gblach/AudioLink/pcb/fab/gerbers/AudioLink-drill-report.txt

Drill report for AudioLink.kicad_pcb
Created on 2026-09-14T11:38:49

Copper Layer Stackup:
    =============================================================
    L1 :  F.Cu                      front
    L2 :  In1.Cu                    in1
    L3 :  In2.Cu                    in2
    L4 :  B.Cu                      back

Drill file 'AudioLink-PTH.drl' contains
    plated through holes:
    =============================================================
    T1  0.300mm  0.0118"  (271 holes))
    T2  0.500mm  0.0197"  (32 holes))
    T3  0.600mm  0.0236"  (4 holes)  (with 4 slots)
    T4  0.650mm  0.0256"  (10 holes))
    T5  1.500mm  0.0591"  (12 holes))
    T6  2.700mm  0.1063"  (4 holes))

    Total plated holes count 333

Drill file 'AudioLink-NPTH.drl' contains
    unplated through holes:
    =============================================================
    T1  0.650mm  0.0256"  (2 holes))

    Total unplated holes count 2
