gblach/AudioLink/pcb/fab/AudioLink-BOM.csv

Item | Designator | Qty | Manufacturer | MPN | Value | Footprint | Type | Notes
1 | C1 | 1 |  |  | 4u7/10V/X7R | C_0805 | SMD | LCSC: https://www.lcsc.com/search?q=4.7uF+0805+10V+X7R
2 | C2,C6,C9,C11,C18-C20,C22,C24,C34-C43 | 19 |  |  | 100n/25V/X7R | C_0603 | SMD | LCSC: https://www.lcsc.com/search?q=100nF+0603+25V+X7R
3 | C3 | 1 |  |  | 10n/50V/X7R | C_0603 | SMD | LCSC: https://www.lcsc.com/search?q=10nF+0603+50V+X7R
4 | C4,C7,C17,C26,C29 | 5 |  |  | 1u/16V/X7R | C_0603 | SMD | LCSC: https://www.lcsc.com/search?q=1uF+0603+16V+X7R
5 | C5,C8,C21,C23,C25 | 5 |  |  | 10u/10V/X7R | C_0805 | SMD | LCSC: https://www.lcsc.com/search?q=10uF+0805+10V+X7R
6 | C10 | 1 |  |  | 22u/10V/X7R | C_0805 | SMD | LCSC: https://www.lcsc.com/search?q=22uF+0805+10V+X7R
7 | C12-C14 | 3 |  |  | 10u/16V/X7R | C_0805 | SMD | LCSC: https://www.lcsc.com/search?q=10uF+0805+16V+X7R
8 | C15,C16 | 2 |  |  | 7p/50V/C0G | C_0603 | SMD | LCSC: https://www.lcsc.com/search?q=7pF+0603+50V+C0G. C0G required - crystal load capacitor
9 | C27,C28 | 2 |  |  | 2u2/16V/X7R | C_0603 | SMD | LCSC: https://www.lcsc.com/search?q=2.2uF+0603+16V+X7R
10 | C30-C33 | 4 |  |  | 100p/50V/C0G | C_0603 | SMD | LCSC: https://www.lcsc.com/search?q=100pF+0603+50V+C0G. C0G required - audio output EMI shunt
11 | D1-D4 | 4 | Worldsemi | WS2812B-4020-V6 | WS2812B-4020-V6 | LED_WS2812B-4020 | SMD | LCSC C52941387 - https://www.lcsc.com/search?q=C52941387
12 | D5 | 1 | Gui guang light | GL0603UB01 | Blue | LED_0603 | SMD | LCSC C51933294 - https://www.lcsc.com/search?q=C51933294. Low-Vf blue, 2.6-2.9V - needed because R19 leaves only 0.4-0.7V across it from the 3V3 rail
13 | D6 | 1 | STMicroelectronics | USBLC6-2SC6 | USBLC6-2SC6 | SOT-23-6 | SMD | LCSC C7519 - https://www.lcsc.com/search?q=C7519. Genuine ST. Cheaper UMW equivalent C2687116 - https://www.lcsc.com/search?q=C2687116
14 | FB1 | 1 | Murata | BLM18PG221SN1D | 220R@100MHz | R_0603 | SMD | LCSC C80165 - https://www.lcsc.com/search?q=C80165
15 | L1,L2 | 2 | Sunlord | SWPA4020S4R7MT | 4u7/1.34A | L_Bourns-SRN4018 | SMD | LCSC C48427 - https://www.lcsc.com/search?q=C48427
16 | R1,R2 | 2 |  |  | 5k1/1% | R_0603 | SMD | LCSC: https://www.lcsc.com/search?q=5.1k+0603+1%. 1% required - USB-C CC pulldown
17 | R3,R12,R13 | 3 |  |  | 100k | R_0603 | SMD | LCSC: https://www.lcsc.com/search?q=100k+0603
18 | R4,R5 | 2 |  |  | 4k7 | R_0603 | SMD | LCSC: https://www.lcsc.com/search?q=4.7k+0603
19 | R7,R17,R18 | 3 |  |  | 0R | R_0603 | SMD | LCSC: https://www.lcsc.com/search?q=0R+0603
20 | R8-R11 | 4 |  |  | 100R/1% | R_0805 | SMD | LCSC: https://www.lcsc.com/search?q=100R+0805+1%. 1% required - these set the balanced source impedance and CMRR
21 | R14,R15 | 2 |  |  | 10k | R_0603 | SMD | LCSC: https://www.lcsc.com/search?q=10k+0603
22 | R16,R19 | 2 |  |  | 470R | R_0603 | SMD | LCSC: https://www.lcsc.com/search?q=470R+0603
23 | U1 | 1 | MinewSemi | MS45SF1-1Y40AIR | MS45SF1 | MinewSemi_MS45SF1 | SMD | Digikey - https://www.digikey.com/en/products/result?keywords=MS45SF1-1Y40AIR. Not stocked at LCSC
24 | U2 | 1 | Texas Instruments | PCM5242RHBR | PCM5242 | VQFN-32 | SMD | LCSC C471871 - https://www.lcsc.com/search?q=C471871
25 | U3,U4 | 2 | Texas Instruments | OPA1678IDR | OPA1678 | SOIC-8 | SMD | LCSC C192421 - https://www.lcsc.com/search?q=C192421
26 | U5 | 1 | Vishay | DG419DY-T1-E3 | DG419 | SOIC-8 | SMD | LCSC C6581 - https://www.lcsc.com/search?q=C6581
27 | U6 | 1 | Texas Instruments | TPS65133DPDR | TPS65133 | WSON-12 | SMD | LCSC C134100 - https://www.lcsc.com/search?q=C134100
28 | U7,U8 | 2 | Texas Instruments | TLV75533PDBVR | TLV75533 | SOT-23-5 | SMD | LCSC C404027 - https://www.lcsc.com/search?q=C404027
29 | Y1 | 1 | Seiko Epson | FC-135 32.7680KA-A5 | 32.768kHz/7pF | Crystal_SMD_3215 | SMD | Digikey - https://www.digikey.com/en/products/result?keywords=FC-135+32.7680KA-A5. LCSC equivalent: Seiko SC-32S C97604, same 3215 / 7pF / 20ppm - https://www.lcsc.com/search?q=C97604
30 | J1,J2 | 2 | Neutrik | NRJ6HM-1 | 6.35mm TRS | Jack_6.35mm_Neutrik_NRJ6HM-1_TrimCrtYd | THT | Mouser 568-NRJ6HM1 - https://www.mouser.com/c/?q=NRJ6HM-1
31 | J3 | 1 | SHOU HAN | TYPE-C 16PIN 2MD(073) | USB-C | USB_C_Receptacle_HCTL_HC-TYPE-C | THT | LCSC C2765186 - https://www.lcsc.com/search?q=C2765186
32 | J4 | 1 | Wurth Elektronik | 62201021621 | SWD | PinHeader_2x05_P1.27mm_Vertical | THT | Digikey - https://www.digikey.com/en/products/result?keywords=62201021621
