gblach/AudioLink/pcb/fab/AudioLink-assembly-top.pdf

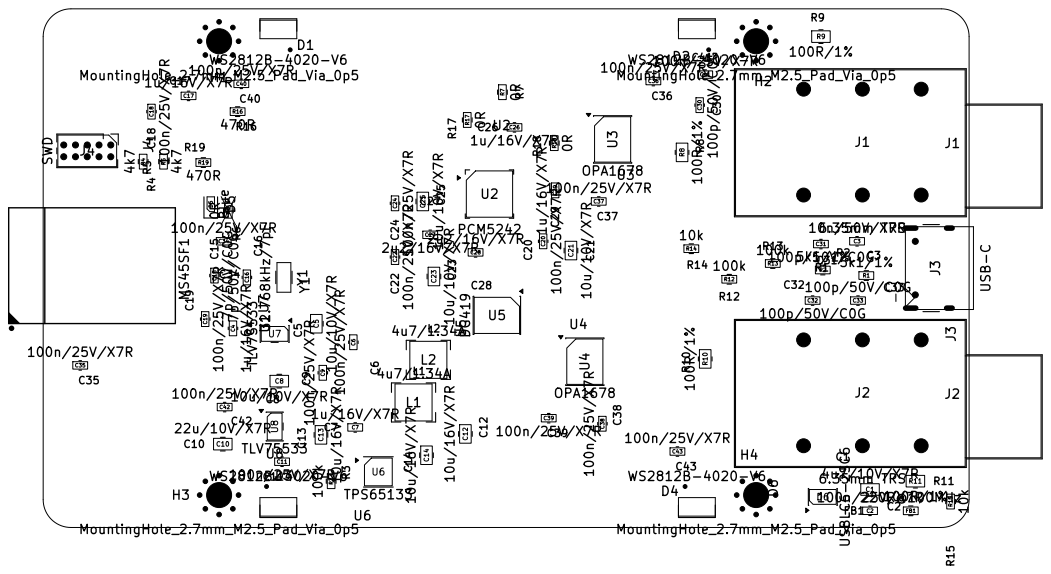
[picture p5: page 1]

Size: A4 | Rev: 1.0
KiCad E.D.A. 10.0.6 | Id: 1/1
