gblach/AudioLink/pcb/fab/AudioLink-schematic.pdf

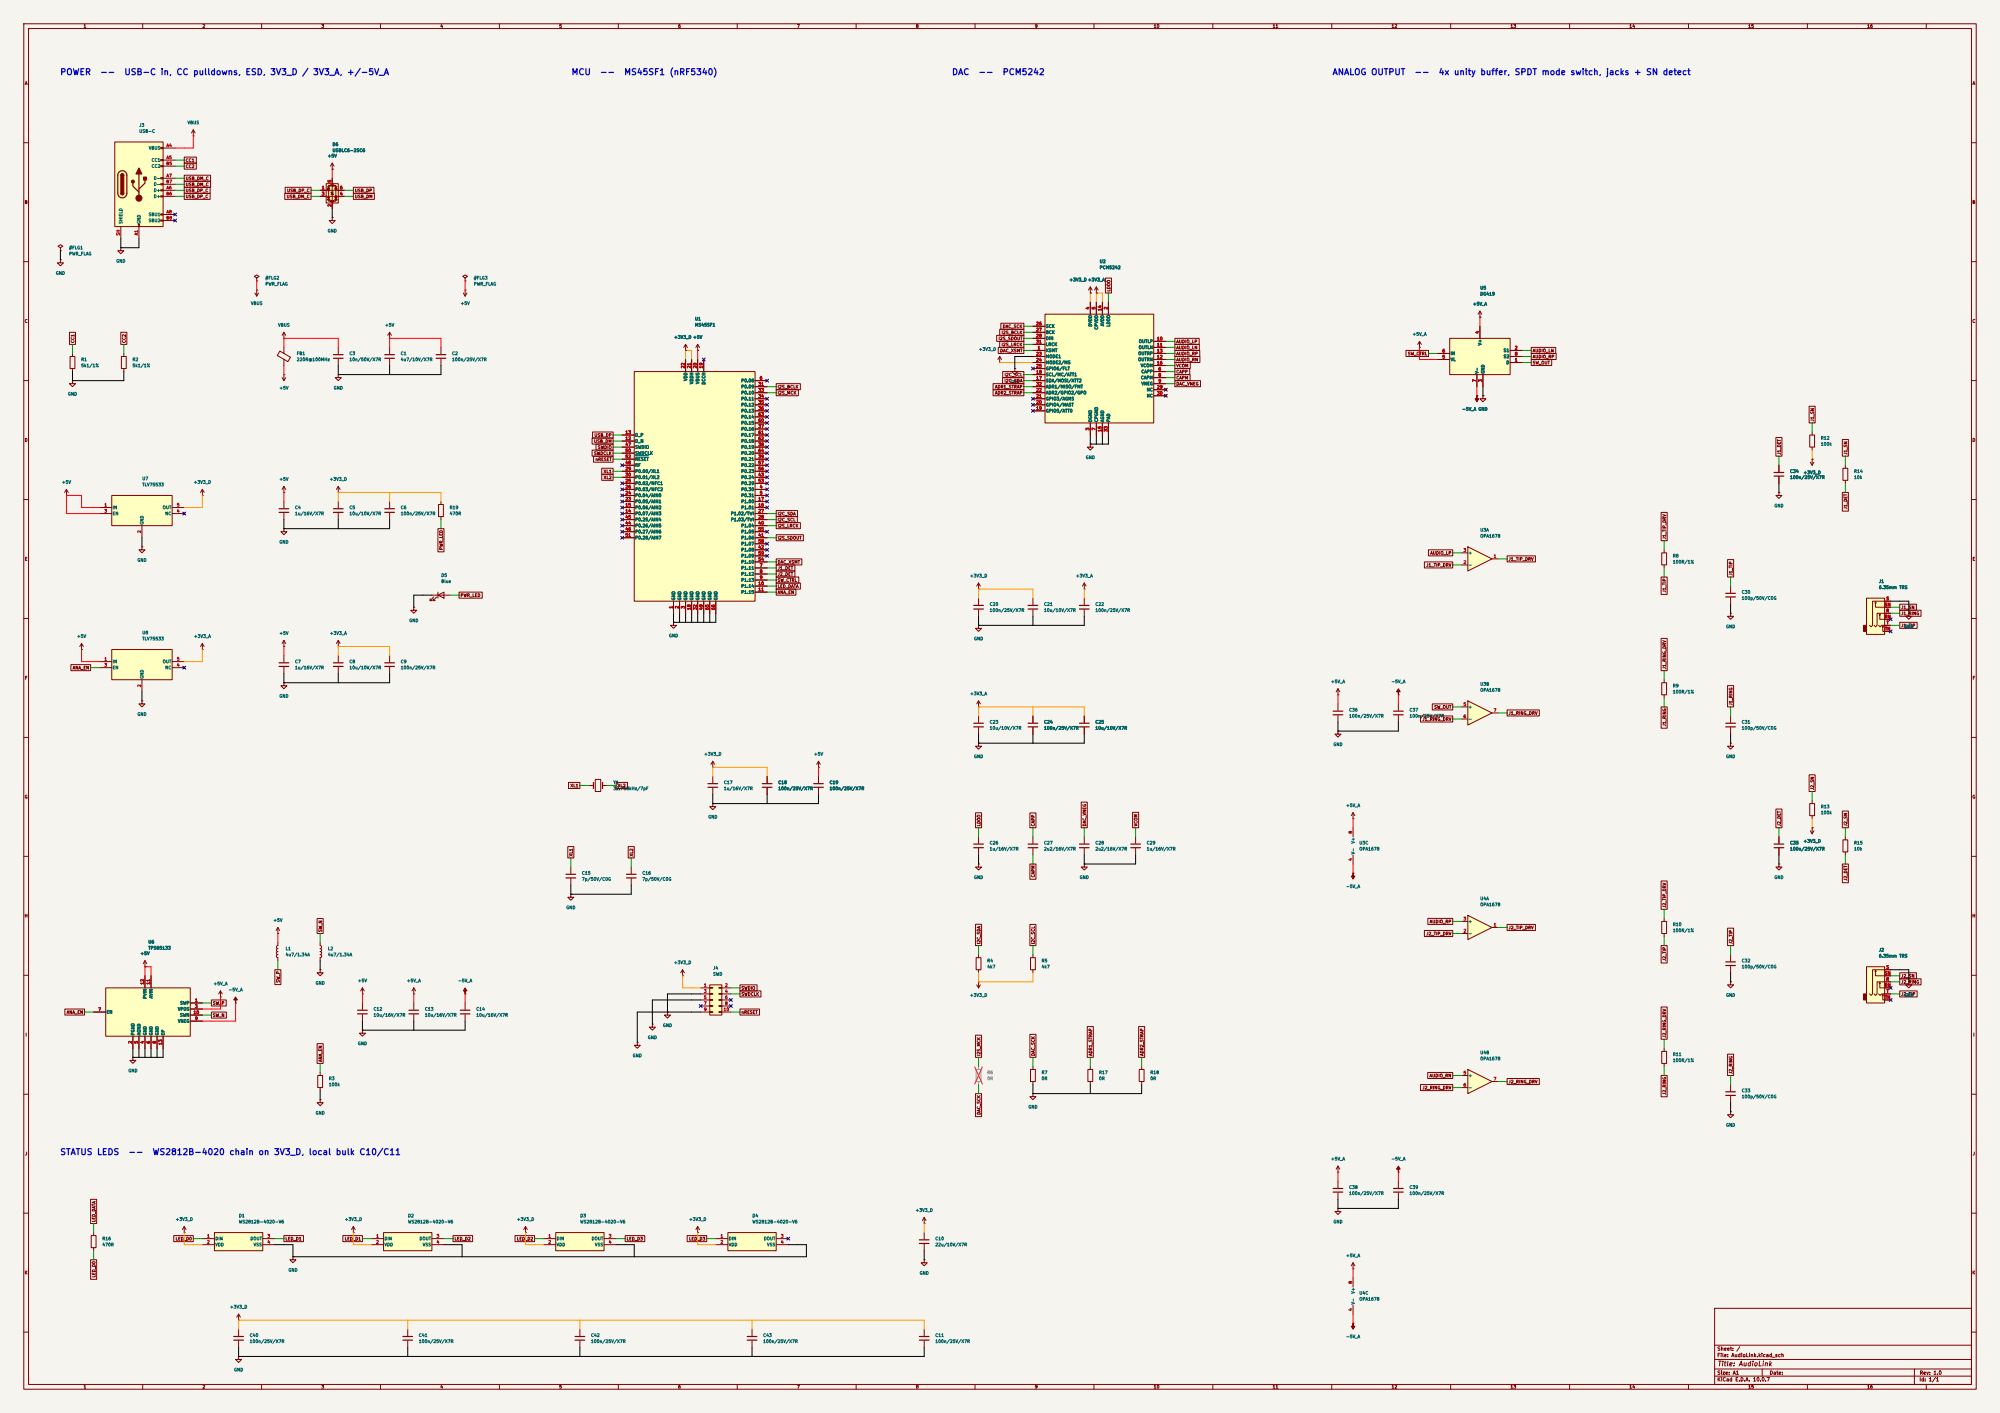
[picture p6: page 1]

3 P0.30 4 P0.31 5 P0.08 6 P1.11 7 P1.12 8 P1.13 9 P1.14 10 P1.15 11 D_N 12 D_P 13 P0.07/AIN3 14 P0.06/AIN2 15 P1.01 16 P1.00 17 GND 18 DCCH 19 VBUS 20 VDDH 21 VDD 22

STATUS LEDS -- WS2812B-4020 chain on 3V3_D, local bulk C10/C11

Size: A1 | Rev: 1.0
KiCad E.D.A. 10.0.7 | Id: 1/1
