gblach/AudioLink/pcb/AudioLink.kicad_pcb

## KiCad design pcb/AudioLink.kicad_pcb (2026-10-31)

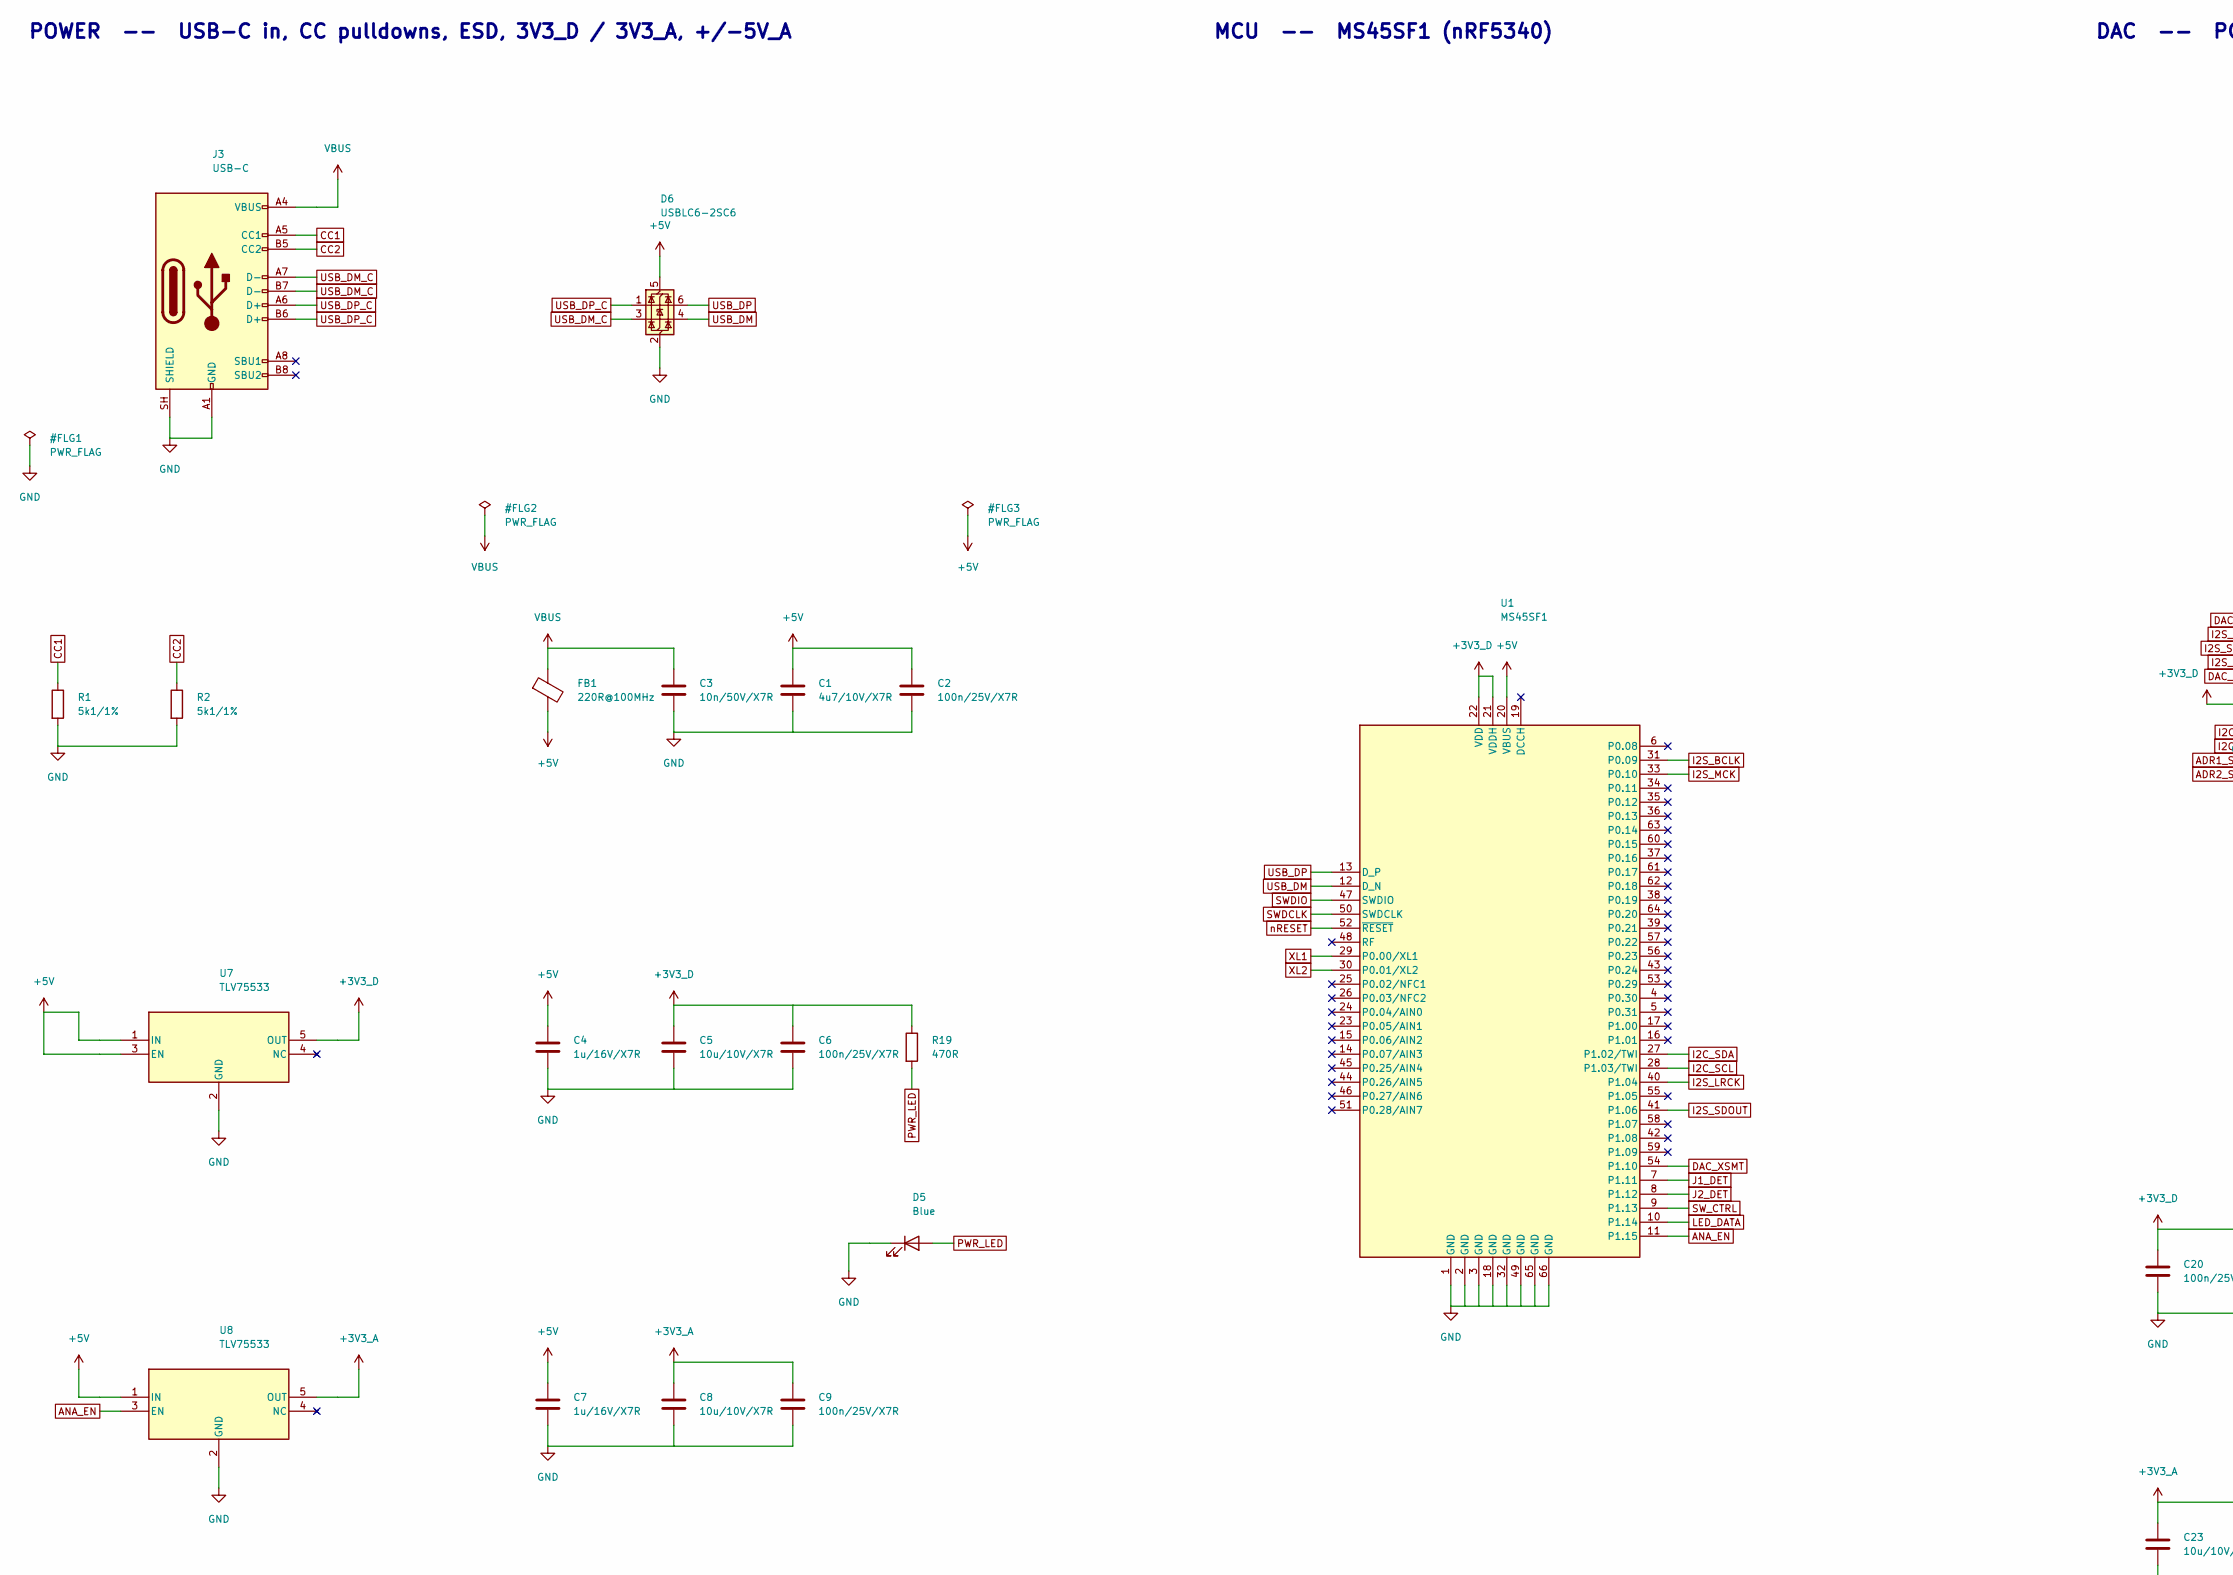
[picture p7: schematic AudioLink.kicad_sch, part in row 1, column 1]

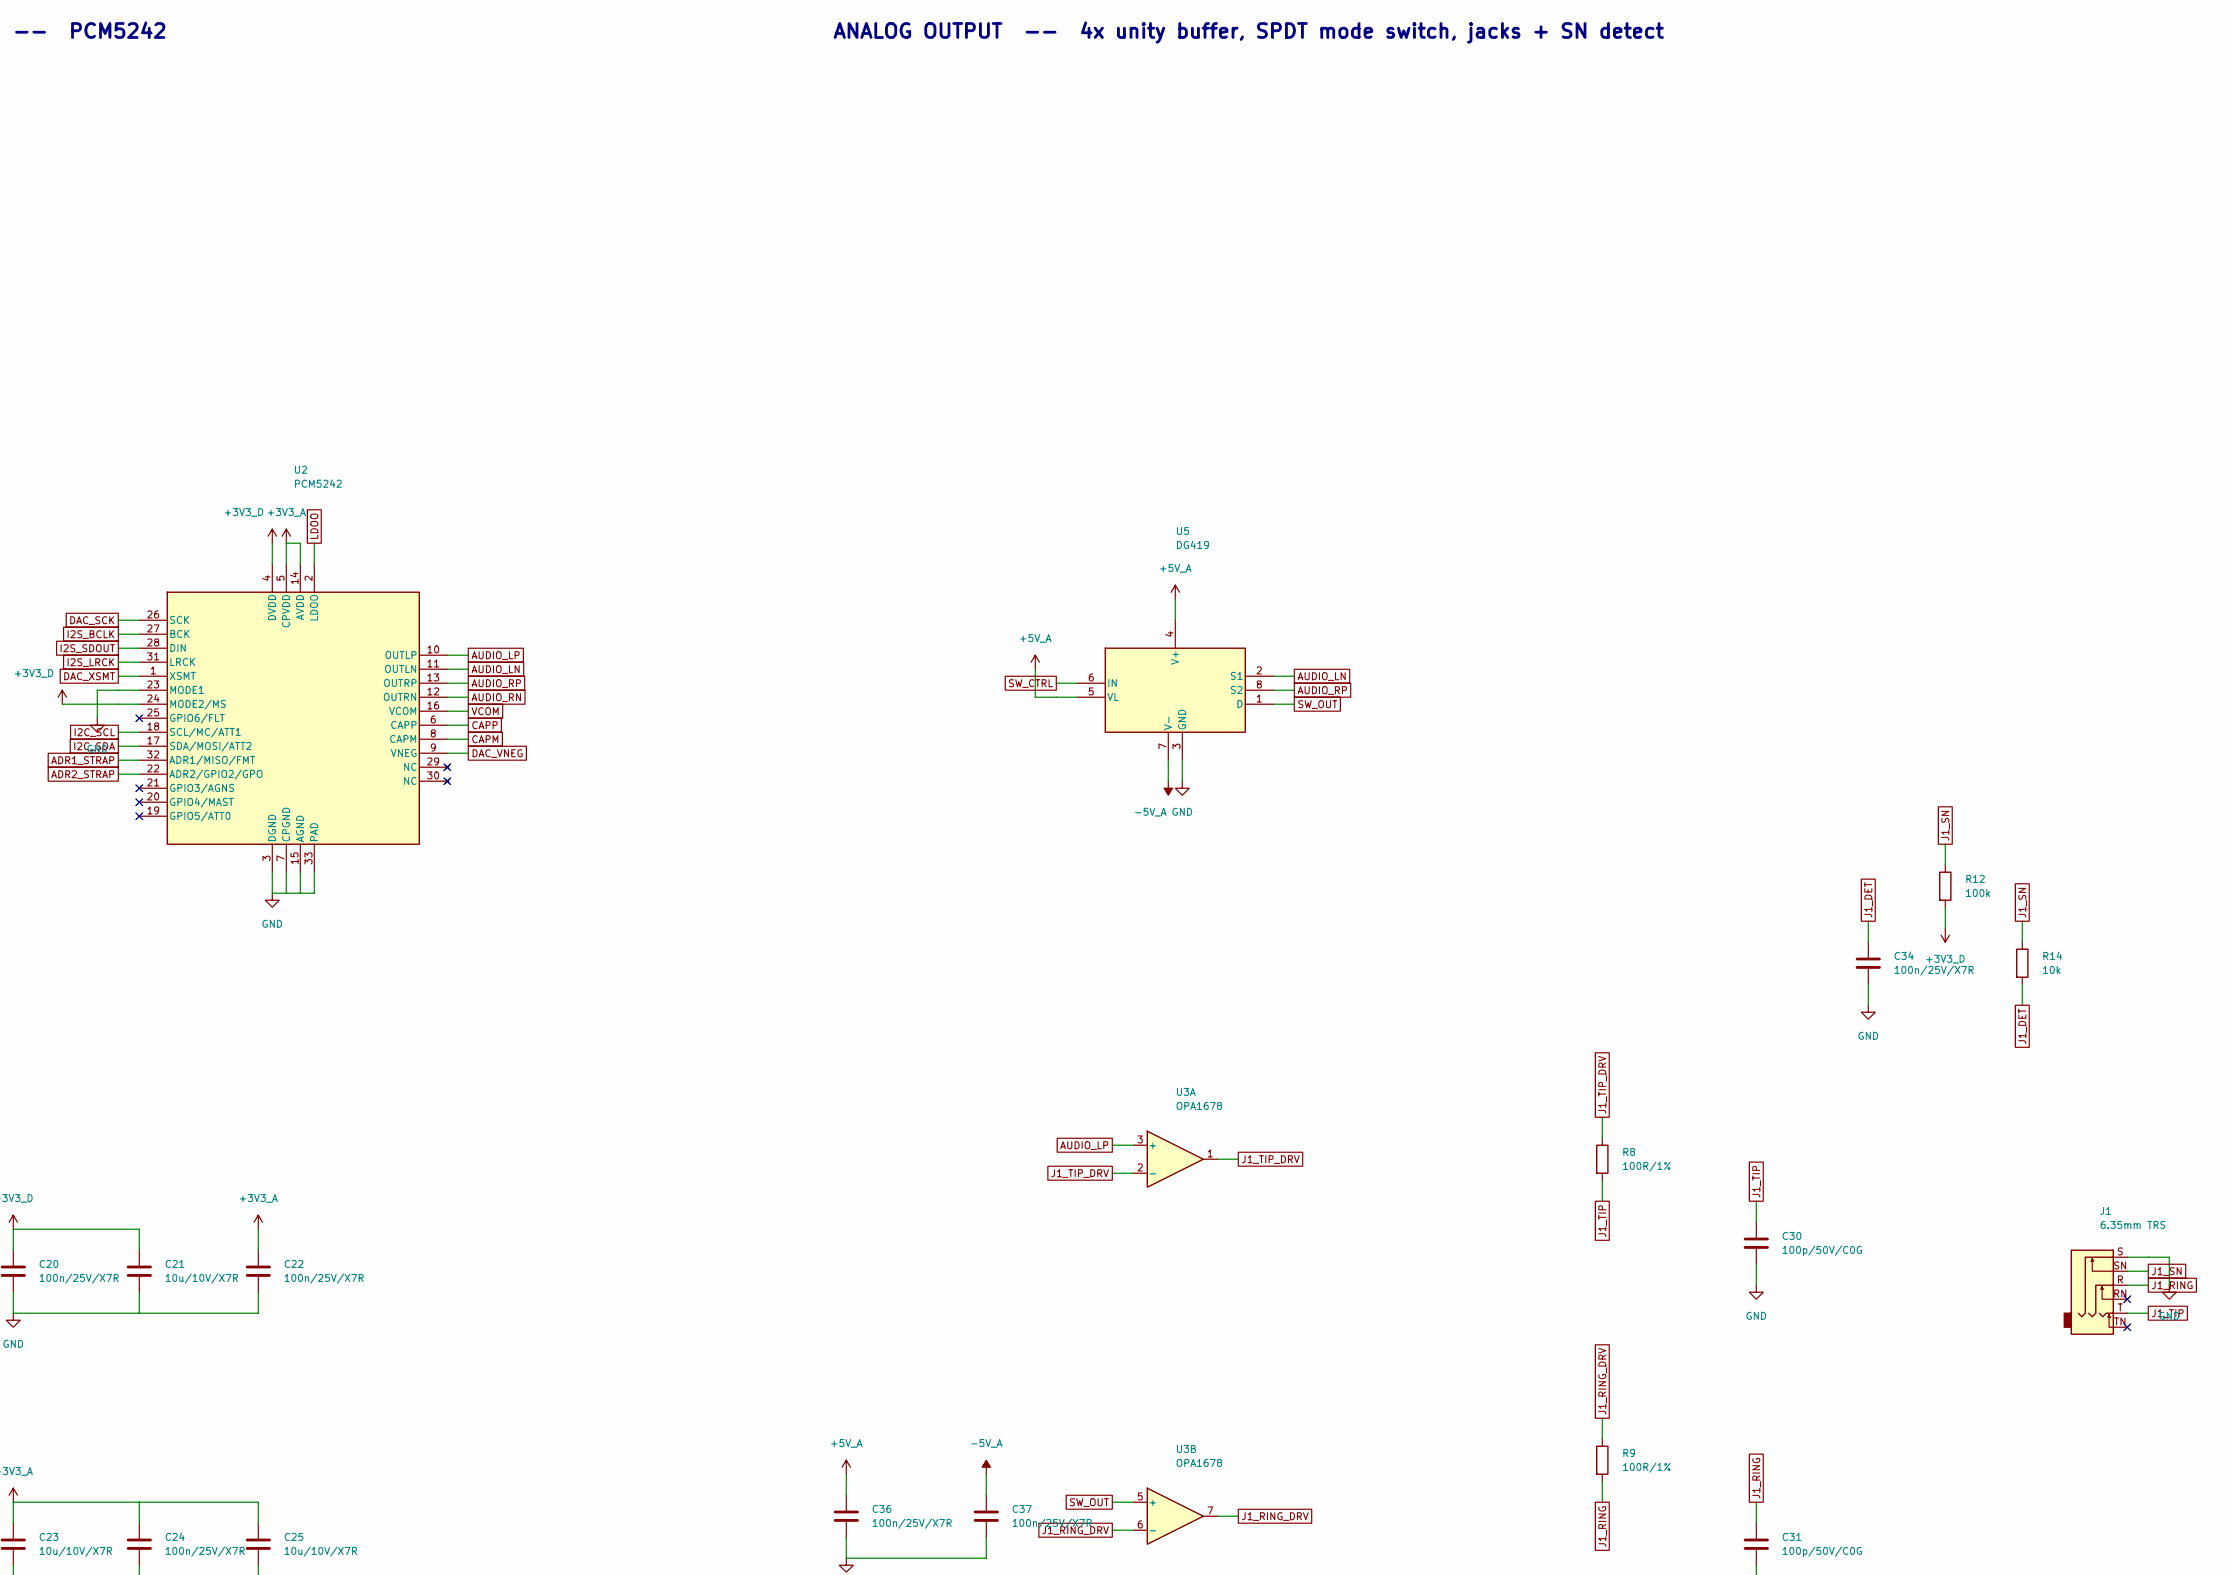
[picture p8: schematic AudioLink.kicad_sch, part in row 1, column 2]

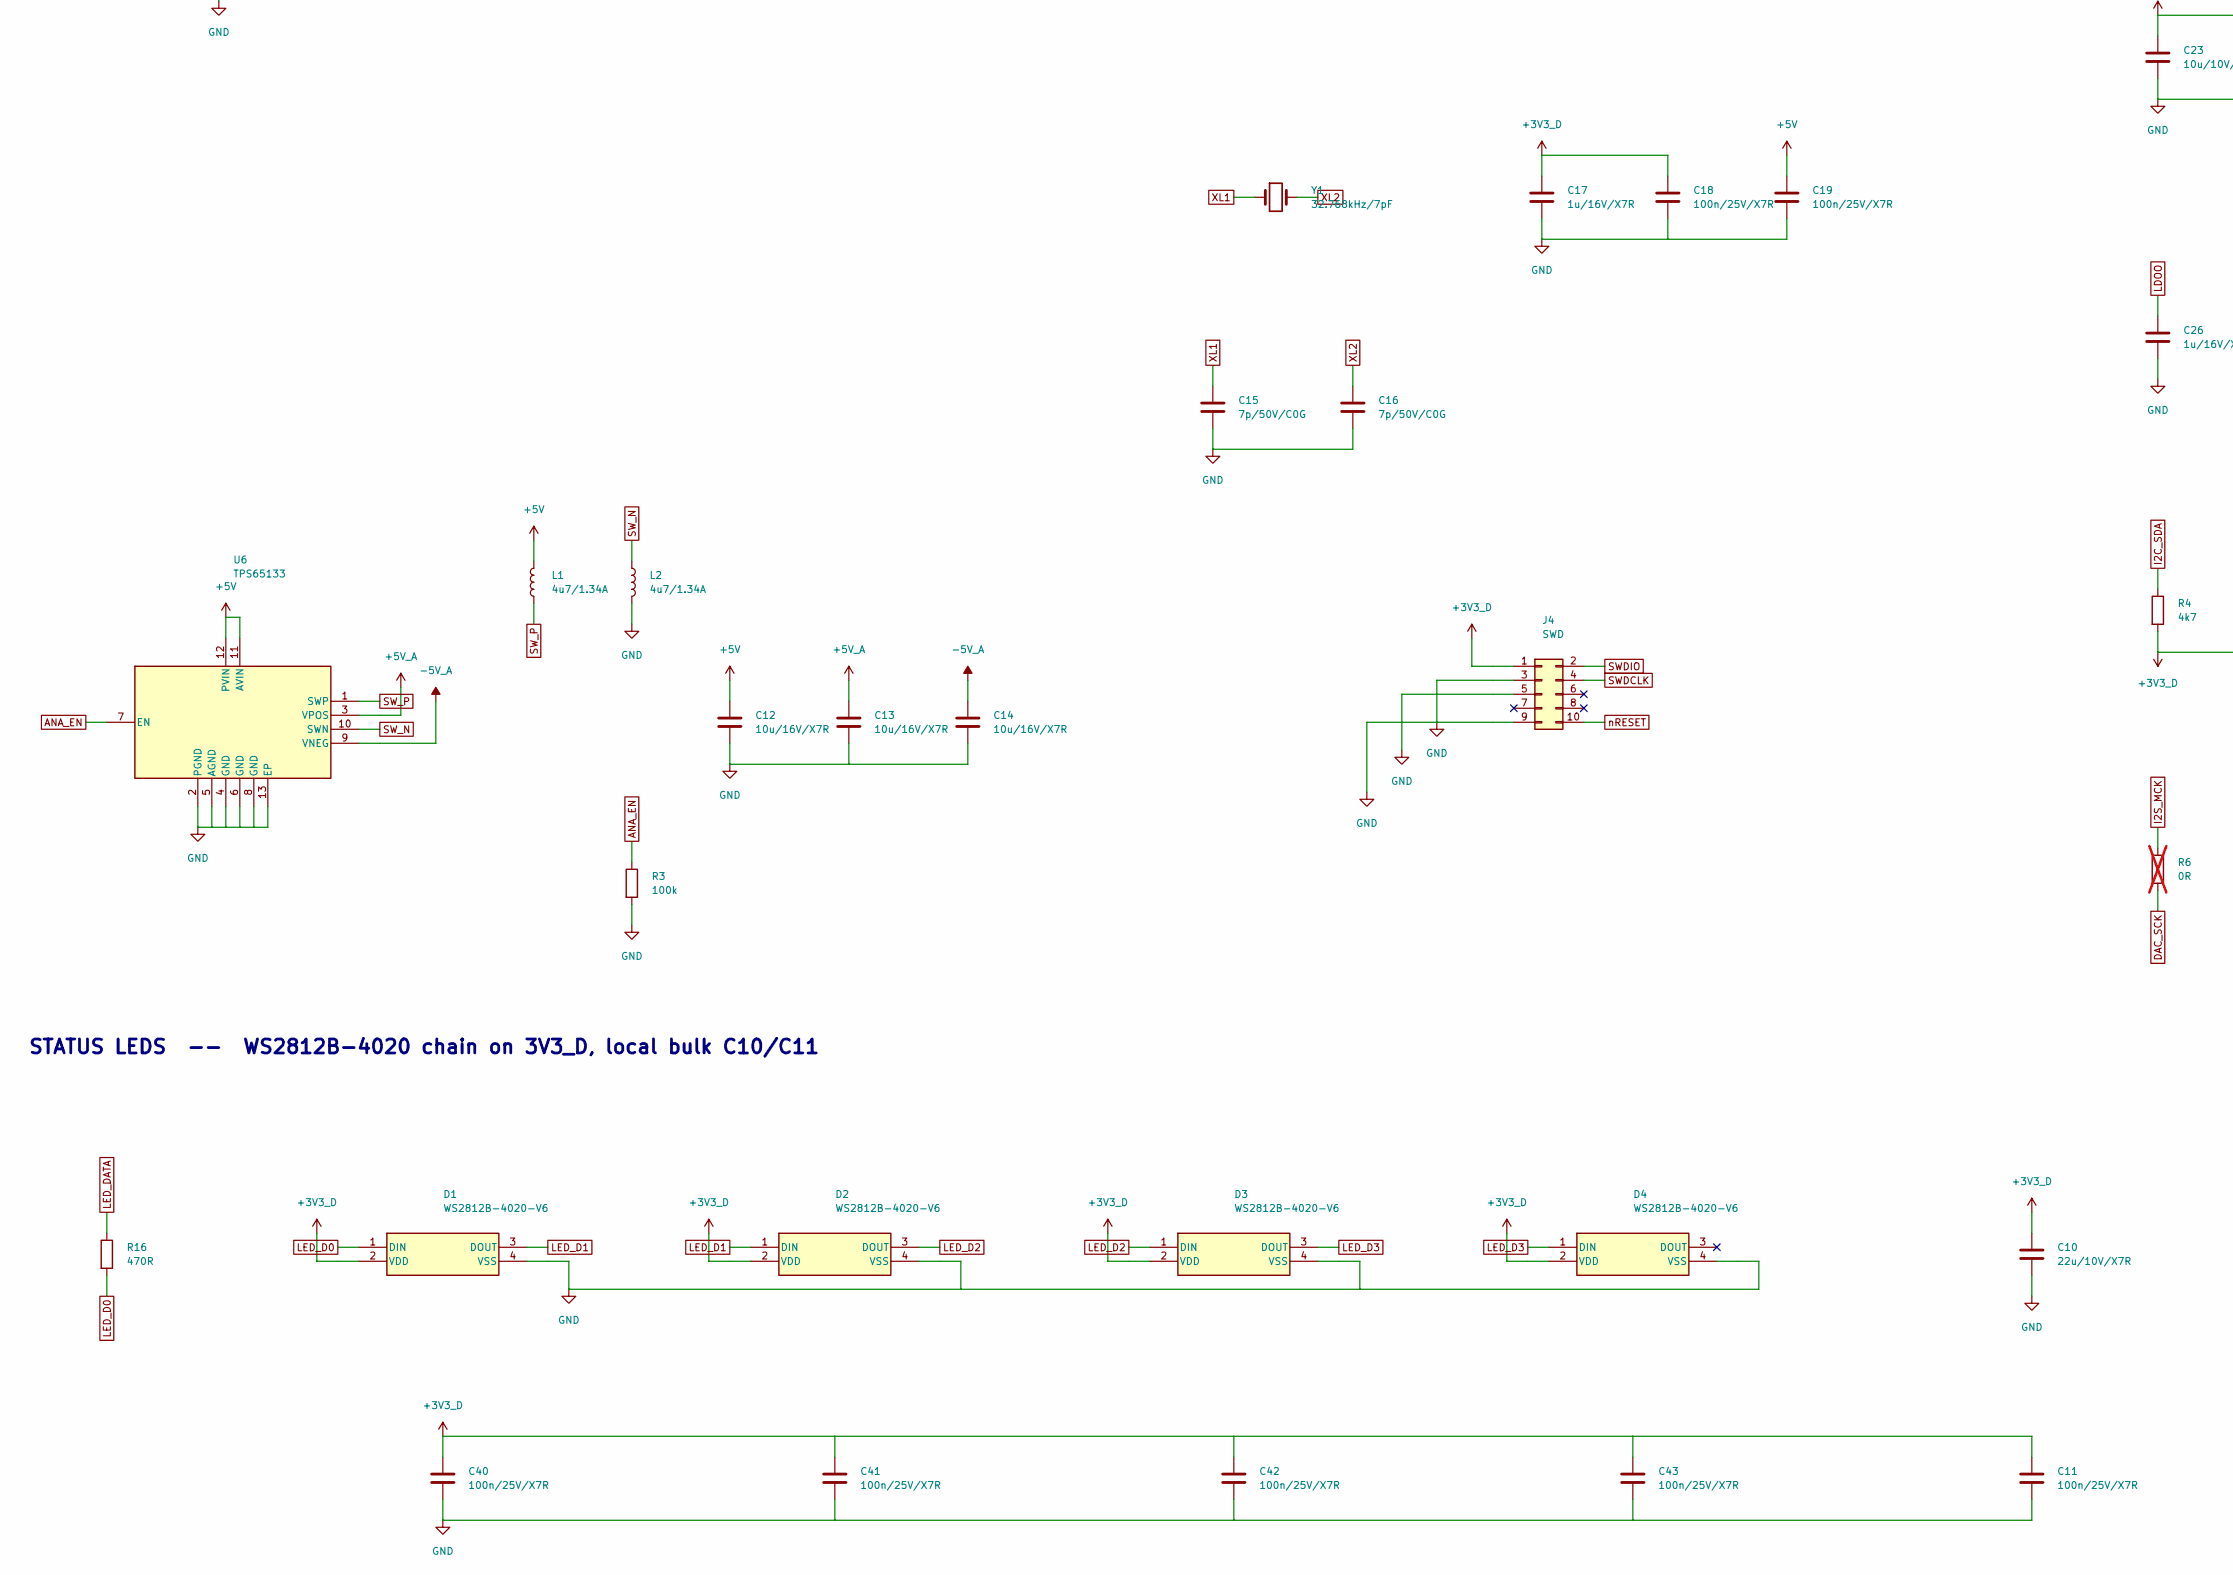
[picture p9: schematic AudioLink.kicad_sch, part in row 2, column 1]

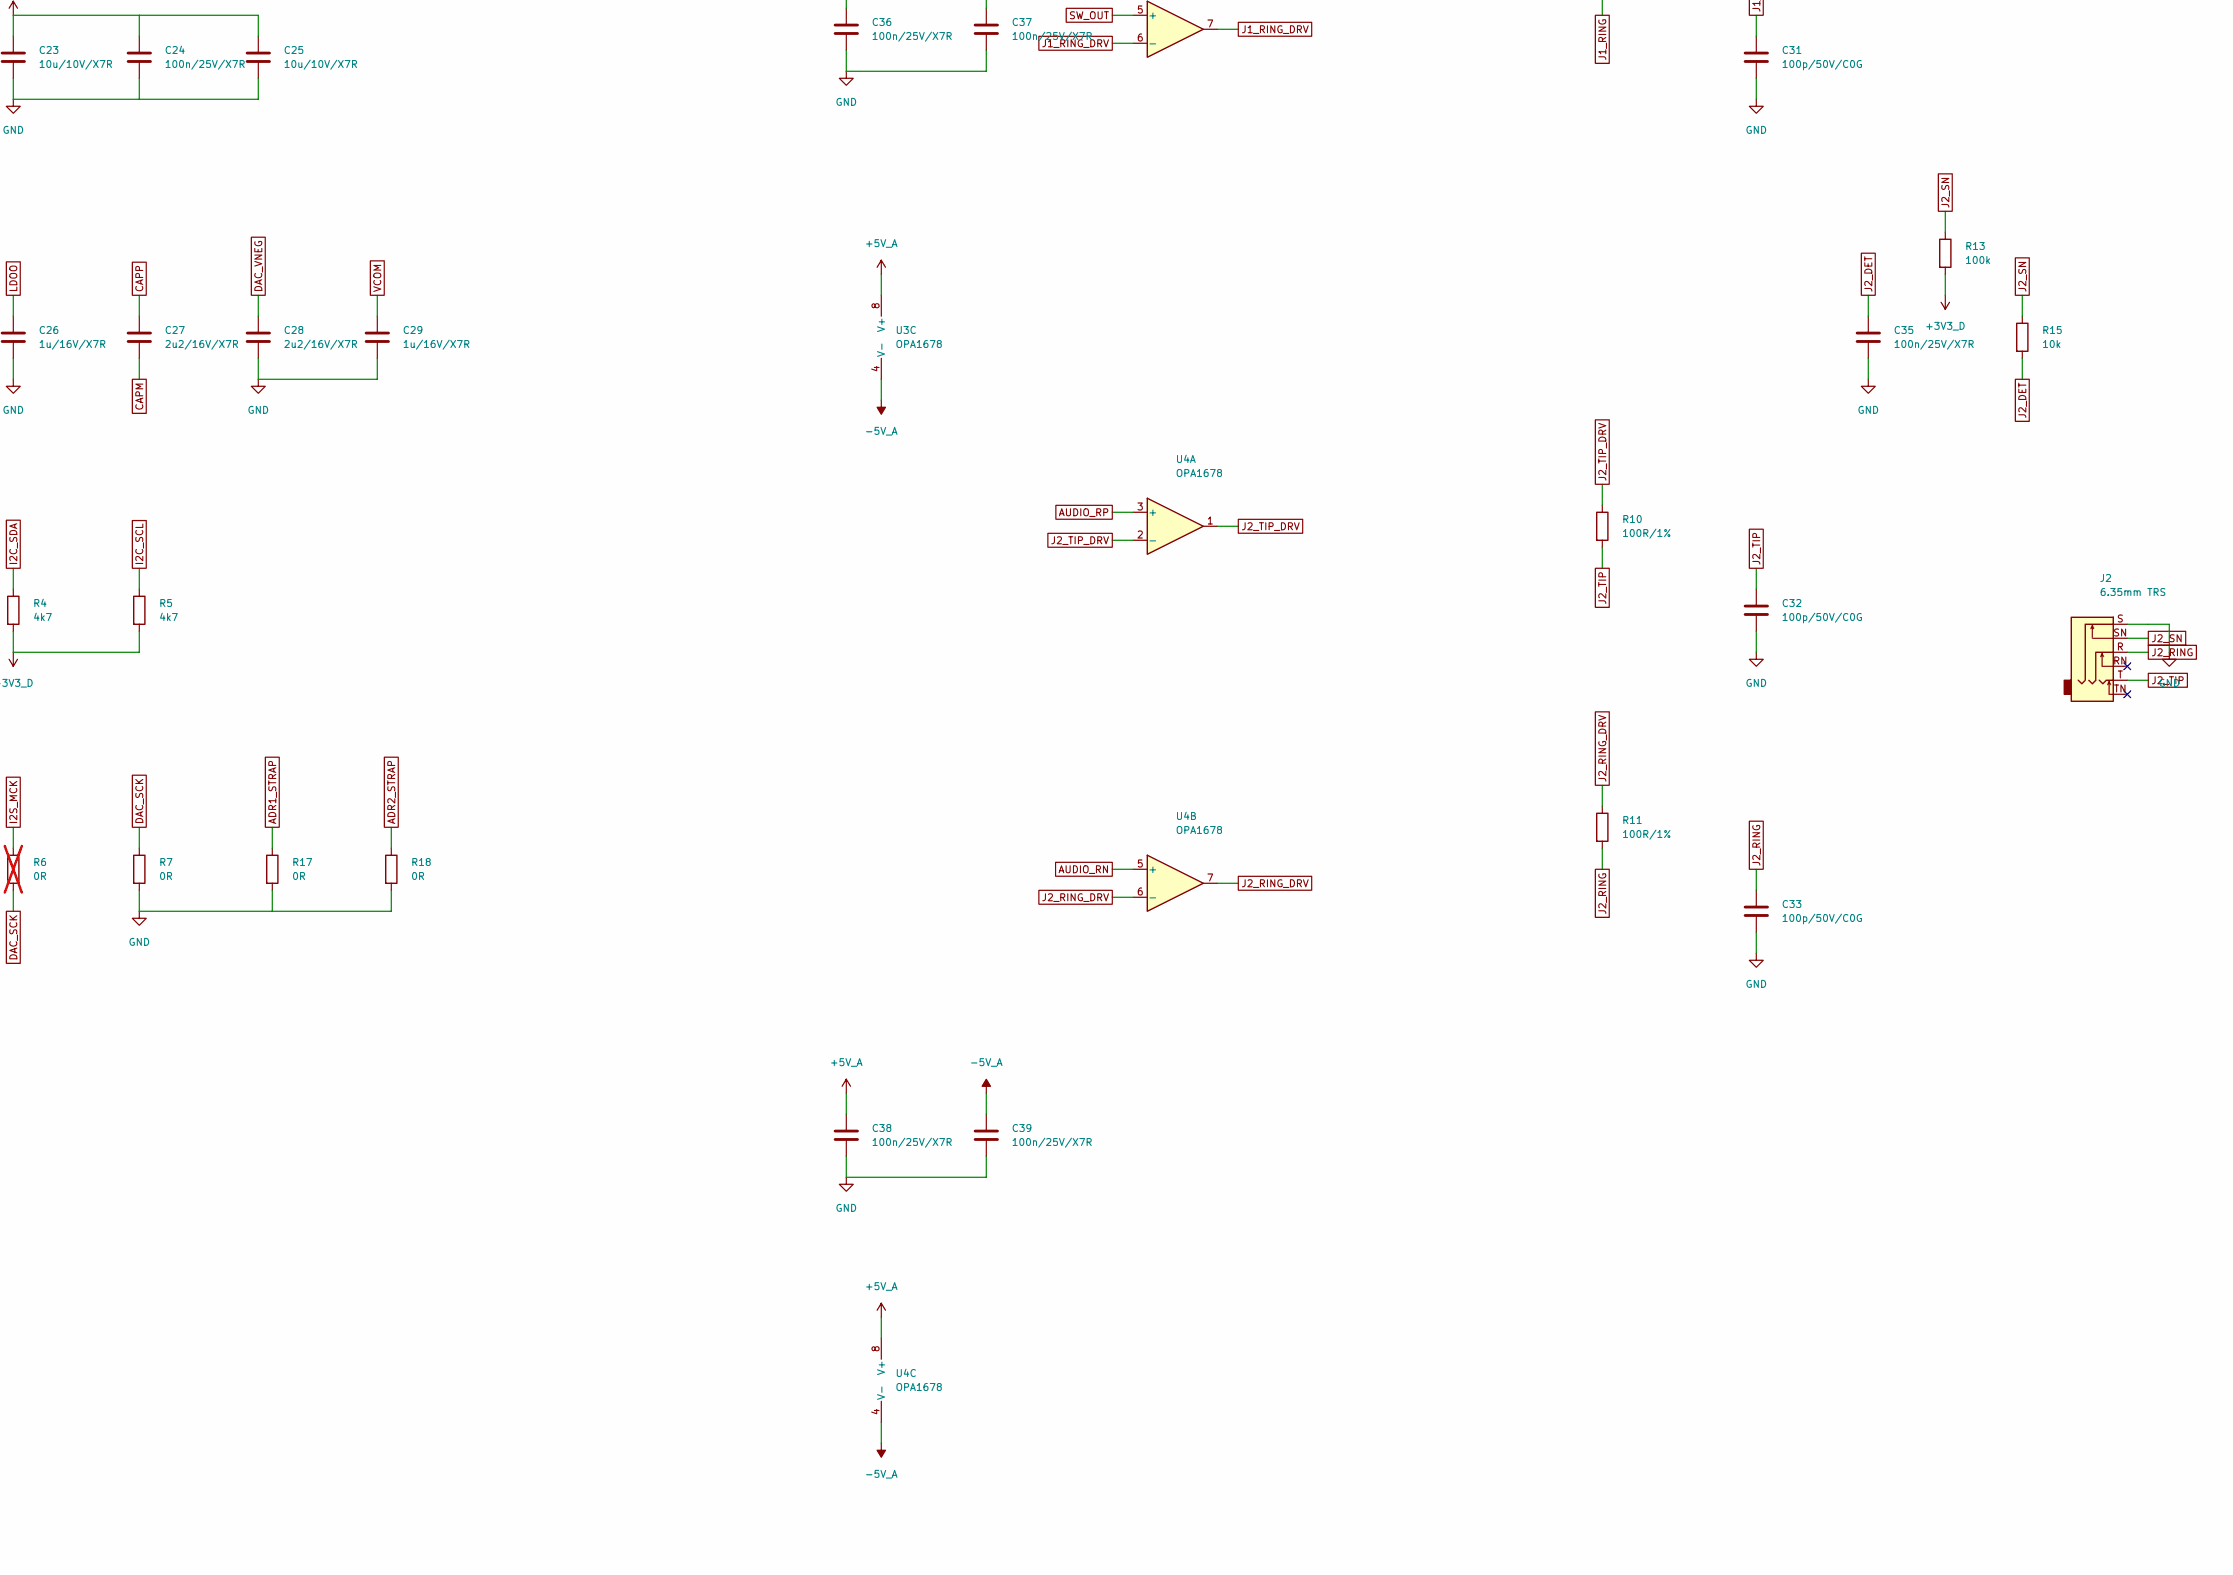
[picture p10: schematic AudioLink.kicad_sch, part in row 2, column 2]

Parts:
C1: 4u7/10V/X7R; C_0805_2012Metric
C2, C6, C9, C11, C18, C19, C20, C22, C24, C34, C35, C36, C37, C38, C39, C40, C41, C42, C43: 100n/25V/X7R; C_0603_1608Metric
C3: 10n/50V/X7R; C_0603_1608Metric
C4, C7, C17, C26, C29: 1u/16V/X7R; C_0603_1608Metric
C5, C8, C21, C23, C25: 10u/10V/X7R; C_0805_2012Metric
C10: 22u/10V/X7R; C_0805_2012Metric
C12, C13, C14: 10u/16V/X7R; C_0805_2012Metric
C15, C16: 7p/50V/C0G; C_0603_1608Metric
C27, C28: 2u2/16V/X7R; C_0603_1608Metric
C30, C31, C32, C33: 100p/50V/C0G; C_0603_1608Metric
D1, D2, D3, D4: WS2812B-4020-V6; LED_WS2812B-4020; MPN WS2812B-4020-V6
D5: Blue; LED_0603_1608Metric; MPN GL0603UB01
D6: USBLC6-2SC6; SOT-23-6; MPN USBLC6-2SC6
FB1: 220R@100MHz; R_0603_1608Metric; MPN BLM18PG221SN1D
J1, J2: 6.35mm TRS; Jack_6.35mm_Neutrik_NRJ6HM-1_TrimCrtYd; MPN NRJ6HM-1
J3: USB-C; USB_C_Receptacle_HCTL_HC-TYPE-C-16P-01A; MPN TYPE-C 16PIN 2MD(073)
J4: SWD; PinHeader_2x05_P1.27mm_Vertical; MPN 62201021621
L1, L2: 4u7/1.34A; L_Bourns-SRN4018; MPN SWPA4020S4R7MT
R1, R2: 5k1/1%; R_0603_1608Metric
R3, R12, R13: 100k; R_0603_1608Metric
R4, R5: 4k7; R_0603_1608Metric
R6: 0R; R_0603_1608Metric; not fitted
R7, R17, R18: 0R; R_0603_1608Metric
R8, R9, R10, R11: 100R/1%; R_0805_2012Metric
R14, R15: 10k; R_0603_1608Metric
R16, R19: 470R; R_0603_1608Metric
U1: MS45SF1; MinewSemi_MS45SF1; MPN MS45SF1-1Y40AIR
U2: PCM5242; VQFN-32-1EP_5x5mm_P0.5mm_EP3.15x3.15mm; MPN PCM5242RHBR
U3, U4: OPA1678; SOIC-8_3.9x4.9mm_P1.27mm; MPN OPA1678IDR
U5: DG419; SOIC-8_3.9x4.9mm_P1.27mm; MPN DG419DY-T1-E3
U6: TPS65133; WSON-12-1EP_3x3mm_P0.5mm_EP1.5x2.5mm; MPN TPS65133DPDR
U7, U8: TLV75533; SOT-23-5; MPN TLV75533PDBVR
Y1: 32.768kHz/7pF; Crystal_SMD_3215-2Pin_3.2x1.5mm; MPN FC-135 32.7680KA-A5

Connections:
+3V3_A: C8.1, C9.1, C22.1, C23.1, C24.1, C25.1, U2.5 (CPVDD), U2.14 (AVDD), U8.5 (OUT)
+3V3_D: C5.1, C6.1, C10.1, C11.1, C17.1, C18.1, C20.1, C21.1, C40.1, C41.1, C42.1, C43.1, D1.2 (VDD), D2.2 (VDD), D3.2 (VDD), D4.2 (VDD), J4.1, R4.2, R5.2, R12.2, R13.2, R19.1, U1.21 (VDDH), U1.22 (VDD), U2.4 (DVDD), U2.24 (MODE2/MS), U7.5 (OUT)
+5V: C1.1, C2.1, C4.1, C7.1, C12.1, C19.1, D6.5 (VBUS), FB1.2, L1.2, U1.20 (VBUS), U6.11 (AVIN), U6.12 (PVIN), U7.1 (IN), U7.3 (EN), U8.1 (IN)
+5V_A: C13.1, C36.1, C38.1, U3.8 (V+), U4.8 (V+), U5.4 (V+), U5.5 (VL), U6.3 (VPOS)
-5V_A: C14.1, C37.1, C39.1, U3.4 (V-), U4.4 (V-), U5.7 (V-), U6.9 (VNEG)
ADR1_STRAP: R17.1, U2.32 (ADR1/MISO/FMT)
ADR2_STRAP: R18.1, U2.22 (ADR2/GPIO2/GPO)
ANA_EN: R3.1, U1.11 (P1.15), U6.7 (EN), U8.3 (EN)
AUDIO_LN: U2.11 (OUTLN), U5.2 (S1)
AUDIO_LP: U2.10 (OUTLP), U3.3 (+)
AUDIO_RN: U2.12 (OUTRN), U4.5 (+)
AUDIO_RP: U2.13 (OUTRP), U4.3 (+), U5.8 (S2)
CAPM: C27.2, U2.8 (CAPM)
CAPP: C27.1, U2.6 (CAPP)
CC1: J3.A5 (CC1), R1.1
CC2: J3.B5 (CC2), R2.1
DAC_SCK: R6.2, R7.1, U2.26 (SCK)
DAC_VNEG: C28.1, U2.9 (VNEG)
DAC_XSMT: U1.54 (P1.10), U2.1 (XSMT)
GND: C1.2, C2.2, C3.2, C4.2, C5.2, C6.2, C7.2, C8.2, C9.2, C10.2, C11.2, C12.2, C13.2, C14.2, C15.2, C16.2, C17.2, C18.2, C19.2, C20.2, C21.2, C22.2, C23.2, C24.2, C25.2, C26.2, C28.2, C29.2, C30.2, C31.2, C32.2, C33.2, C34.2, C35.2, C36.2, C37.2, C38.2, C39.2, C40.2, C41.2, C42.2, C43.2, D1.4 (VSS), D2.4 (VSS), D3.4 (VSS), D4.4 (VSS), D5.1 (K), D6.2 (GND), J1.S, J2.S, J3.A1 (GND), J3.A12 (GND), J3.B1 (GND), J3.B12 (GND), J3.SH (SHIELD), J4.3, J4.5, J4.9, L2.2, R1.2, R2.2, R3.2, R7.2, R17.2, R18.2, U1.1 (GND), U1.2 (GND), U1.3 (GND), U1.18 (GND), U1.32 (GND), U1.49 (GND), U1.65 (GND), U1.66 (GND), U2.3 (DGND), U2.7 (CPGND), U2.15 (AGND), U2.23 (MODE1), U2.33 (PAD), U5.3 (GND), U6.2 (PGND), U6.4 (GND), U6.5 (AGND), U6.6 (GND), U6.8 (GND), U6.13 (EP), U7.2 (GND), U8.2 (GND); also elsewhere on the board
I2C_SCL: R5.1, U1.28 (P1.03/TWI), U2.18 (SCL/MC/ATT1)
I2C_SDA: R4.1, U1.27 (P1.02/TWI), U2.17 (SDA/MOSI/ATT2)
I2S_BCLK: U1.31 (P0.09), U2.27 (BCK)
I2S_LRCK: U1.40 (P1.04), U2.31 (LRCK)
I2S_MCK: R6.1, U1.33 (P0.10)
I2S_SDOUT: U1.41 (P1.06), U2.28 (DIN)
J1_DET: C34.1, R14.2, U1.7 (P1.11)
J1_RING: C31.1, J1.R, R9.2
J1_RING_DRV: R9.1, U3.6 (-), U3.7
J1_SN: J1.SN, R12.1, R14.1
J1_TIP: C30.1, J1.T, R8.2
J1_TIP_DRV: R8.1, U3.1, U3.2 (-)
J2_DET: C35.1, R15.2, U1.8 (P1.12)
J2_RING: C33.1, J2.R, R11.2
J2_RING_DRV: R11.1, U4.6 (-), U4.7
J2_SN: J2.SN, R13.1, R15.1
J2_TIP: C32.1, J2.T, R10.2
J2_TIP_DRV: R10.1, U4.1, U4.2 (-)
LDOO: C26.1, U2.2 (LDOO)
LED_D0: D1.1 (DIN), R16.2
LED_D1: D1.3 (DOUT), D2.1 (DIN)
LED_D2: D2.3 (DOUT), D3.1 (DIN)
LED_D3: D3.3 (DOUT), D4.1 (DIN)
LED_DATA: R16.1, U1.10 (P1.14)
PWR_LED: D5.2 (A), R19.2
SWDCLK: J4.4, U1.50 (SWDCLK)
SWDIO: J4.2, U1.47 (SWDIO)
SW_CTRL: U1.9 (P1.13), U5.6 (IN)
SW_N: L2.1, U6.10 (SWN)
SW_OUT: U3.5 (+), U5.1 (D)
SW_P: L1.1, U6.1 (SWP)
USB_DM: D6.4 (I/O2), U1.12 (D_N)
USB_DM_C: D6.3 (I/O2), J3.A7 (D-), J3.B7 (D-)
USB_DP: D6.6 (I/O1), U1.13 (D_P)
USB_DP_C: D6.1 (I/O1), J3.A6 (D+), J3.B6 (D+)
VBUS: C3.1, FB1.1, J3.A4 (VBUS), J3.A9 (VBUS), J3.B4 (VBUS), J3.B9 (VBUS)
VCOM: C29.1, U2.16 (VCOM)
XL1: C15.1, U1.29 (P0.00/XL1), Y1.1
XL2: C16.1, U1.30 (P0.01/XL2), Y1.2
nRESET: J4.10, U1.52 (~RESET)

Notes on the sheet:
POWER -- USB-C in, CC pulldowns, ESD, 3V3_D / 3V3_A, +/-5V_A
MCU -- MS45SF1 (nRF5340)
DAC -- PCM5242
ANALOG OUTPUT -- 4x unity buffer, SPDT mode switch, jacks + SN detect
STATUS LEDS -- WS2812B-4020 chain on 3V3_D, local bulk C10/C11

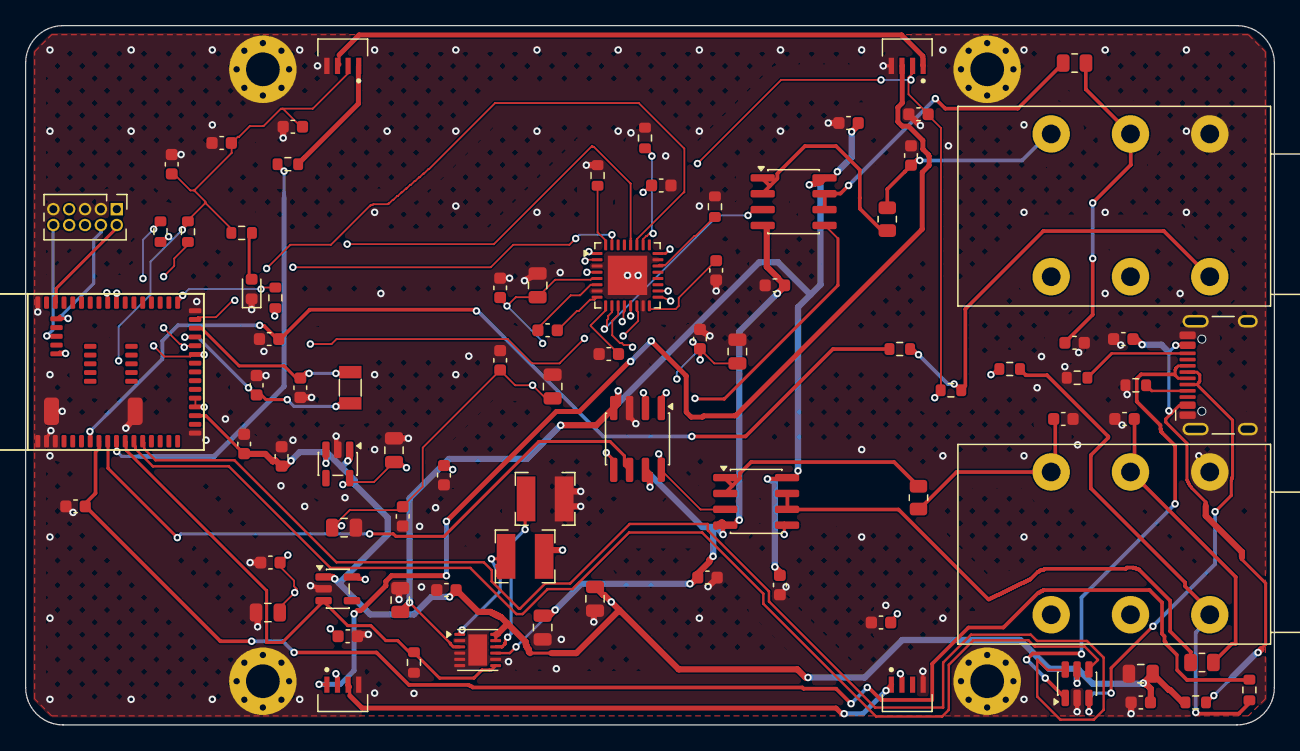
[picture p11: board AudioLink.kicad_pcb from above]

Board: 4 copper layers, 100.0 x 56.0 mm, 88 parts (0 on the bottom side), 60 nets.

Other parts of the board:
H1, H2, H3, H4: MountingHole_2.7mm_M2.5_Pad_Via_0p5

Their connections:
GND: H1.1, H2.1, H3.1, H4.1; also elsewhere on the board
