gblach/AudioLink/(commit log)

2026-10-31 Initial import
    [AudioLink-BOM.csv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]
2026-11-05 Release 0.1.3: add test signal mode
    Add a GATT characteristic that switches the output to a built-in pink noise test signal,
    with a toggle in the Android app. Replace the 0.1.2 release files with 0.1.3.
    [audio_out.c, audio_out.h, control.c, test_signal.c, test_signal.h]
